zatch10/ECE445/README.md

# ECE445
Demo video: https://drive.google.com/file/d/1n-CQ_gI9pz3HDdr53e14W1SXyg3exWH_/view
