zatch10/ECE445/notebook/Vatsin/Board_inspect_1.jpeg

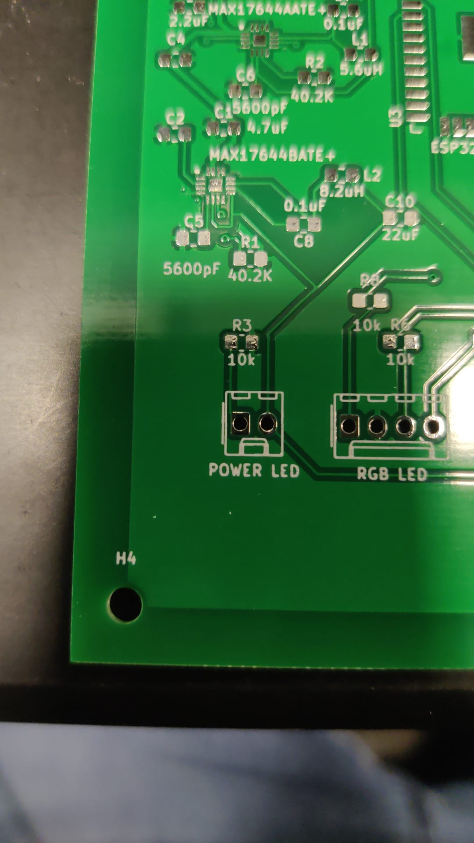
notebook/Vatsin/Board_inspect_1.jpeg
