zatch10/ECE445/notebook/Vatsin/full_board_power_on_bottom.jpeg

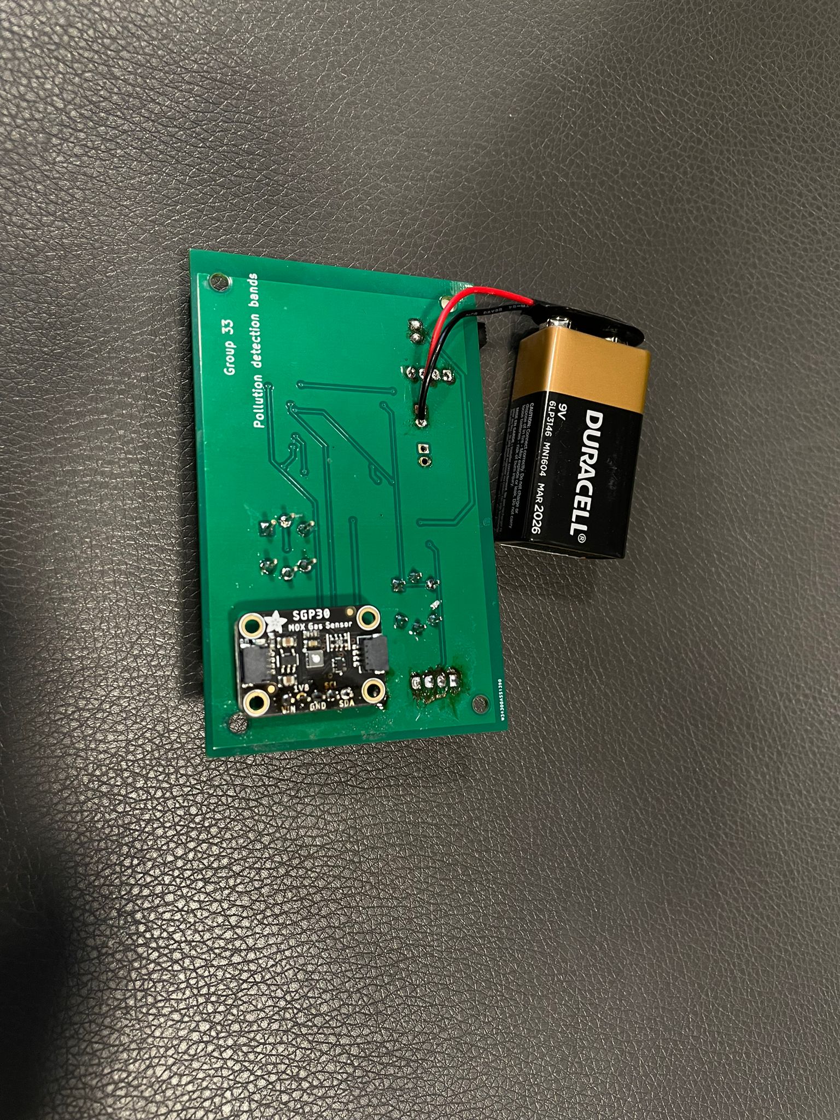
notebook/Vatsin/full_board_power_on_bottom.jpeg
