zatch10/ECE445/notebook/Vatsin/full_enclosure_closed.jpeg

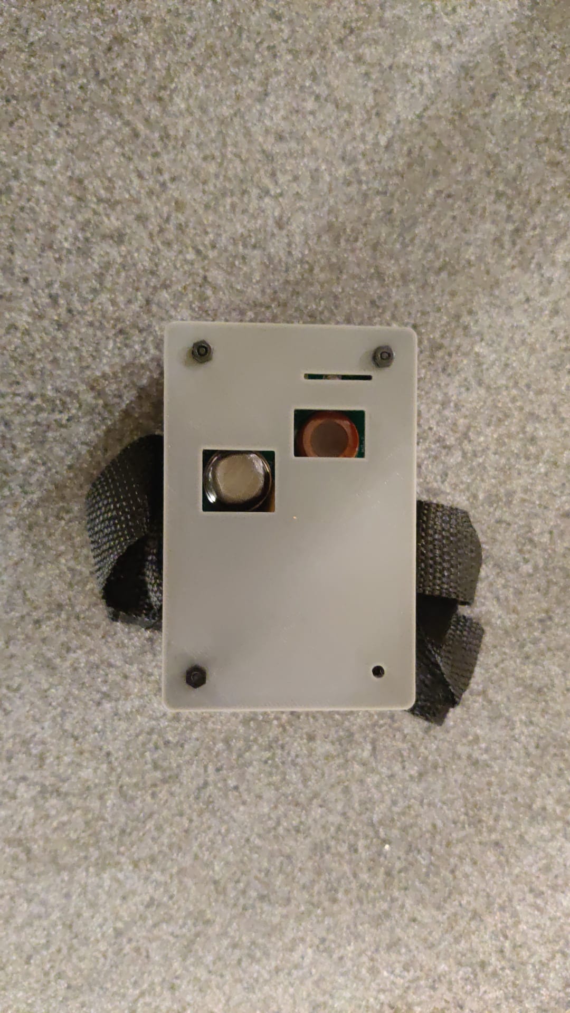
notebook/Vatsin/full_enclosure_closed.jpeg
