zatch10/ECE445/notebook/Chirag/Top.STL

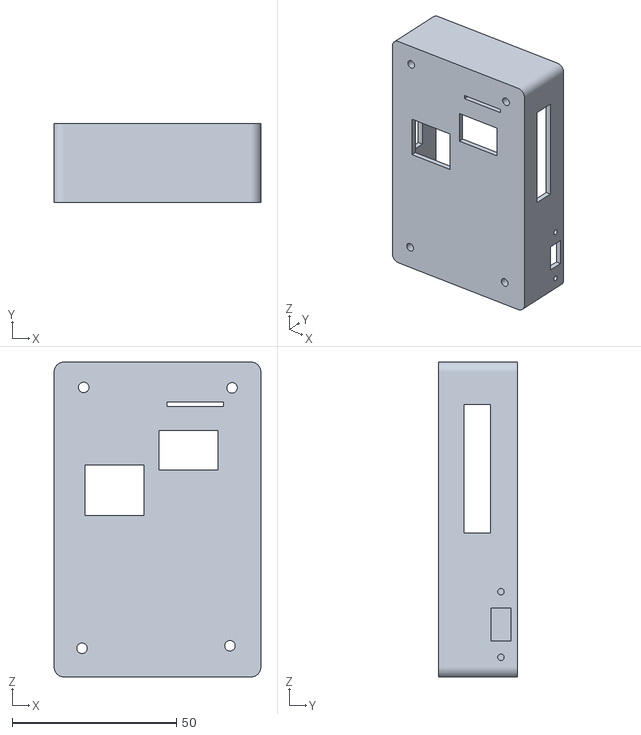
[picture p43: CAD file, 2022-05-06]
notebook/Chirag/Top.STL
63.0 x 24.0 x 96.0
