zatch10/ECE445/notebook/Chirag/Bottom.STL

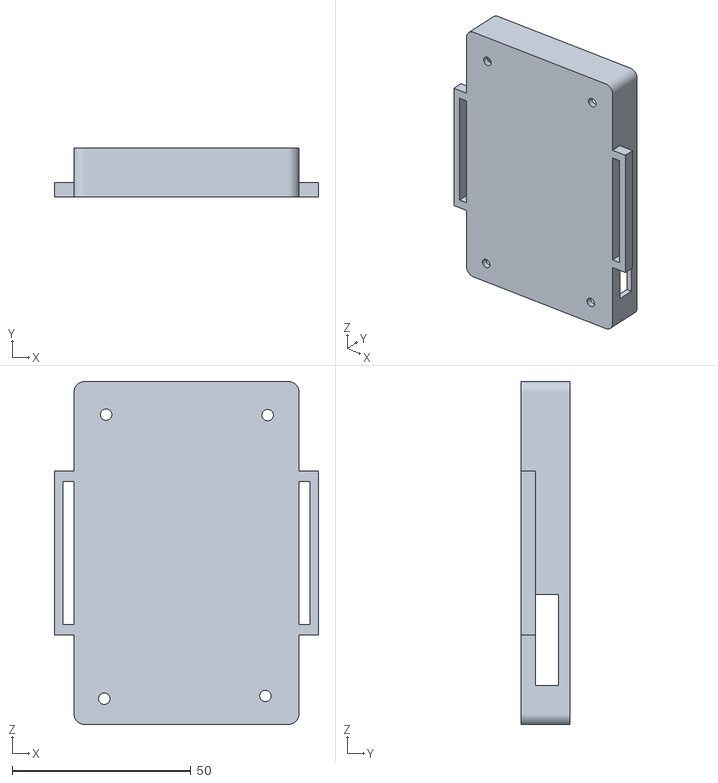
[picture p44: CAD file, 2022-05-06]
notebook/Chirag/Bottom.STL
74.0 x 13.6 x 96.0
