zatch10/ECE445/notebook/Chirag/Connectivity Tests.jpg

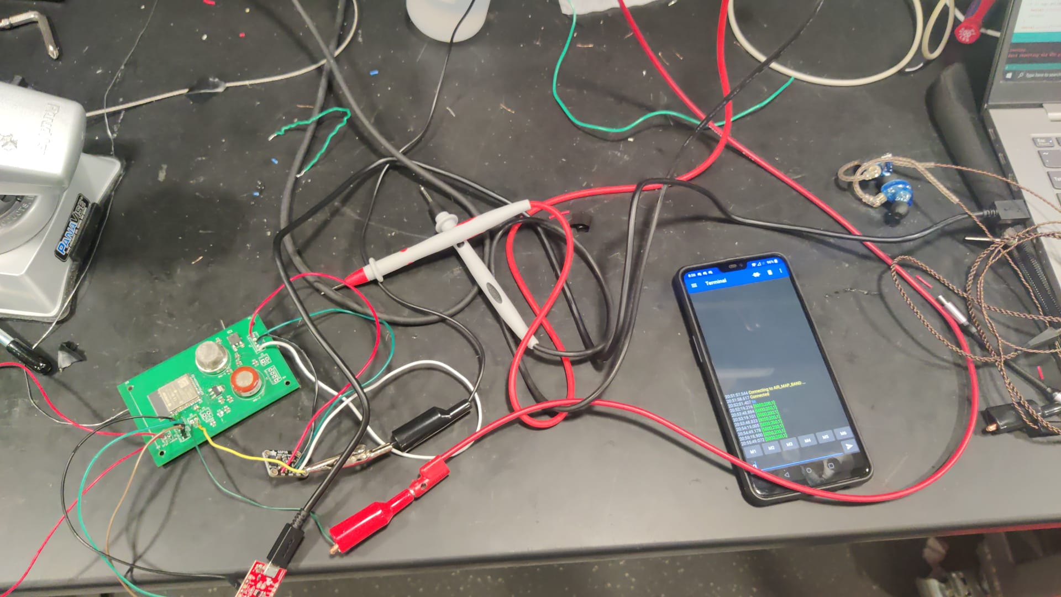
notebook/Chirag/Connectivity Tests.jpg
