zatch10/ECE445/(commit log)

2022-04-17 arduino code
2022-05-06 Added images
    [Bottom.STL, Top.STL]
